chunyinkwong/infill-journal/(list of files, cad)

Other CAD files:
CAD/Frame.f3z
