chunyinkwong/infill-journal/(commit log)

2025-04-04 add PCB information
2025-04-12 Add CAD to repo
    [Frame.f3z]
2025-04-14 fix BOM
2025-04-14 add links to BOM
